yuliusd/I-Gauge/README.md

# I-Gauge
Open Source Hardware for monitoring water pipe pressure
