yuliusd/I-Gauge/I-GAUGE LoRa EndNode.png

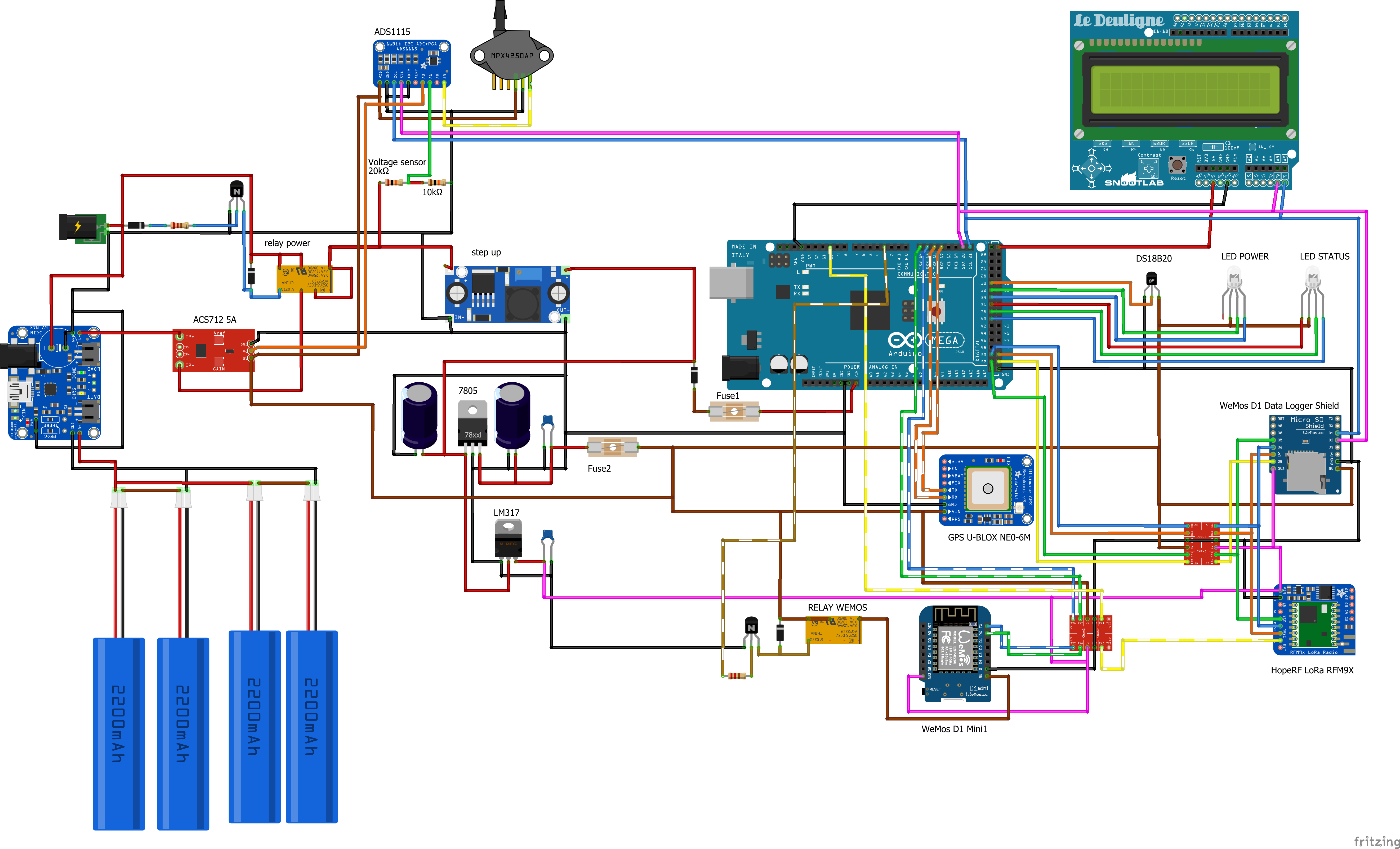
I-GAUGE LoRa EndNode.png
