yuliusd/I-Gauge/i-gauge LoRa Gateway.png

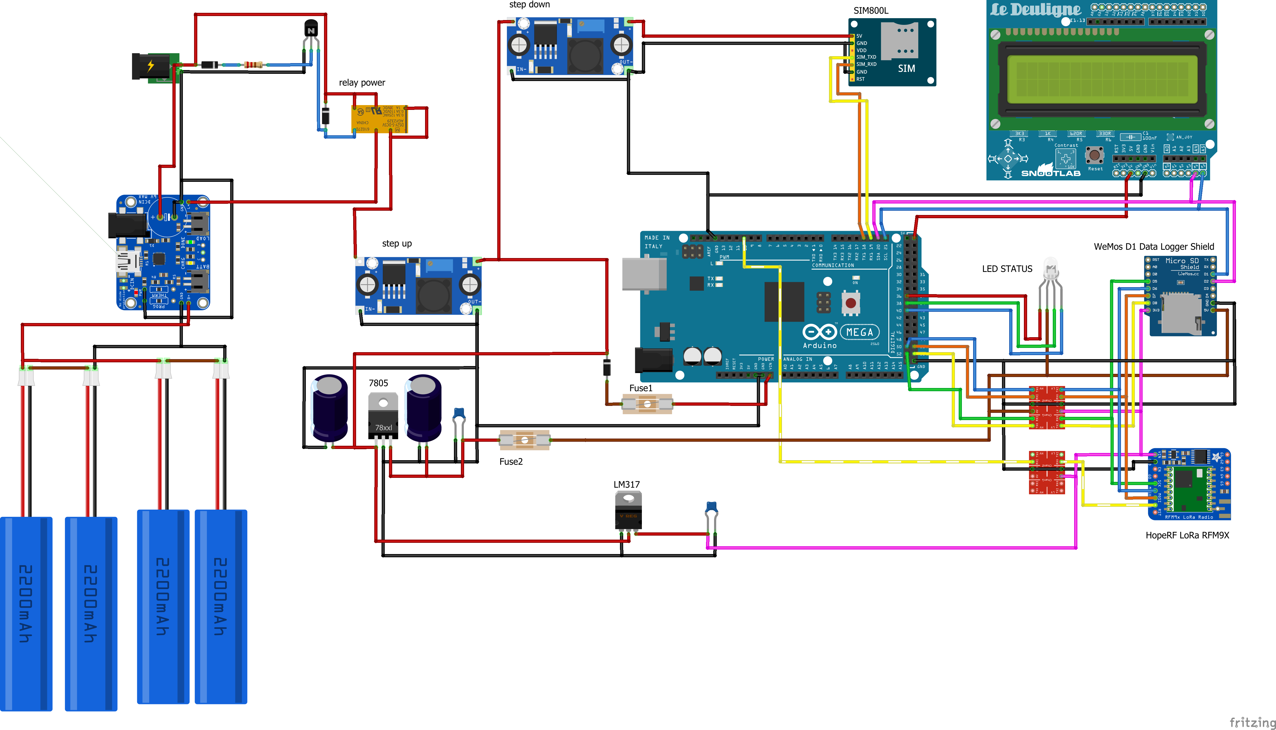
i-gauge LoRa Gateway.png
