yuliusd/I-Gauge/I-GAUGE_versi complete.png

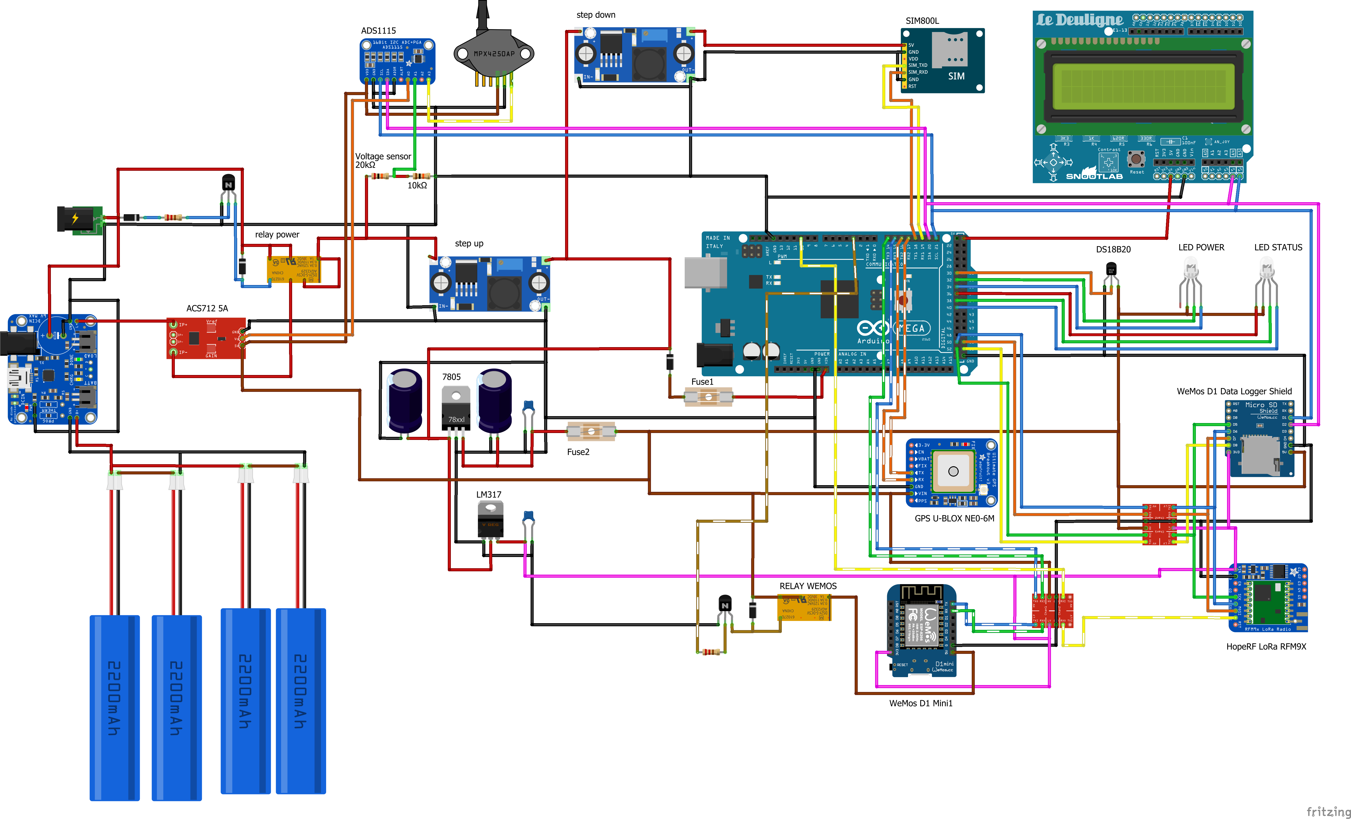
I-GAUGE_versi complete.png
