yuliusd/I-Gauge/igauge.png

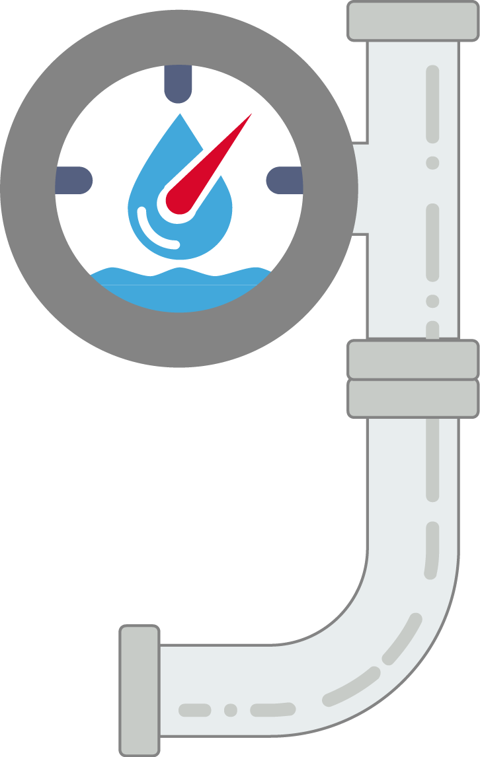
igauge.png
