yuliusd/I-Gauge/(list of files, drawings)

Other design files:
I-GAUGE COMPLETE VERSION.fzz
I-GAUGE LoRa EndNode.fzz
i-gauge LoRa Gateway.fzz
