yuliusd/I-Gauge/IGauge+V.2.2.brd

## EAGLE design IGauge+V.2.2.brd (2018-05-09, an earlier design)

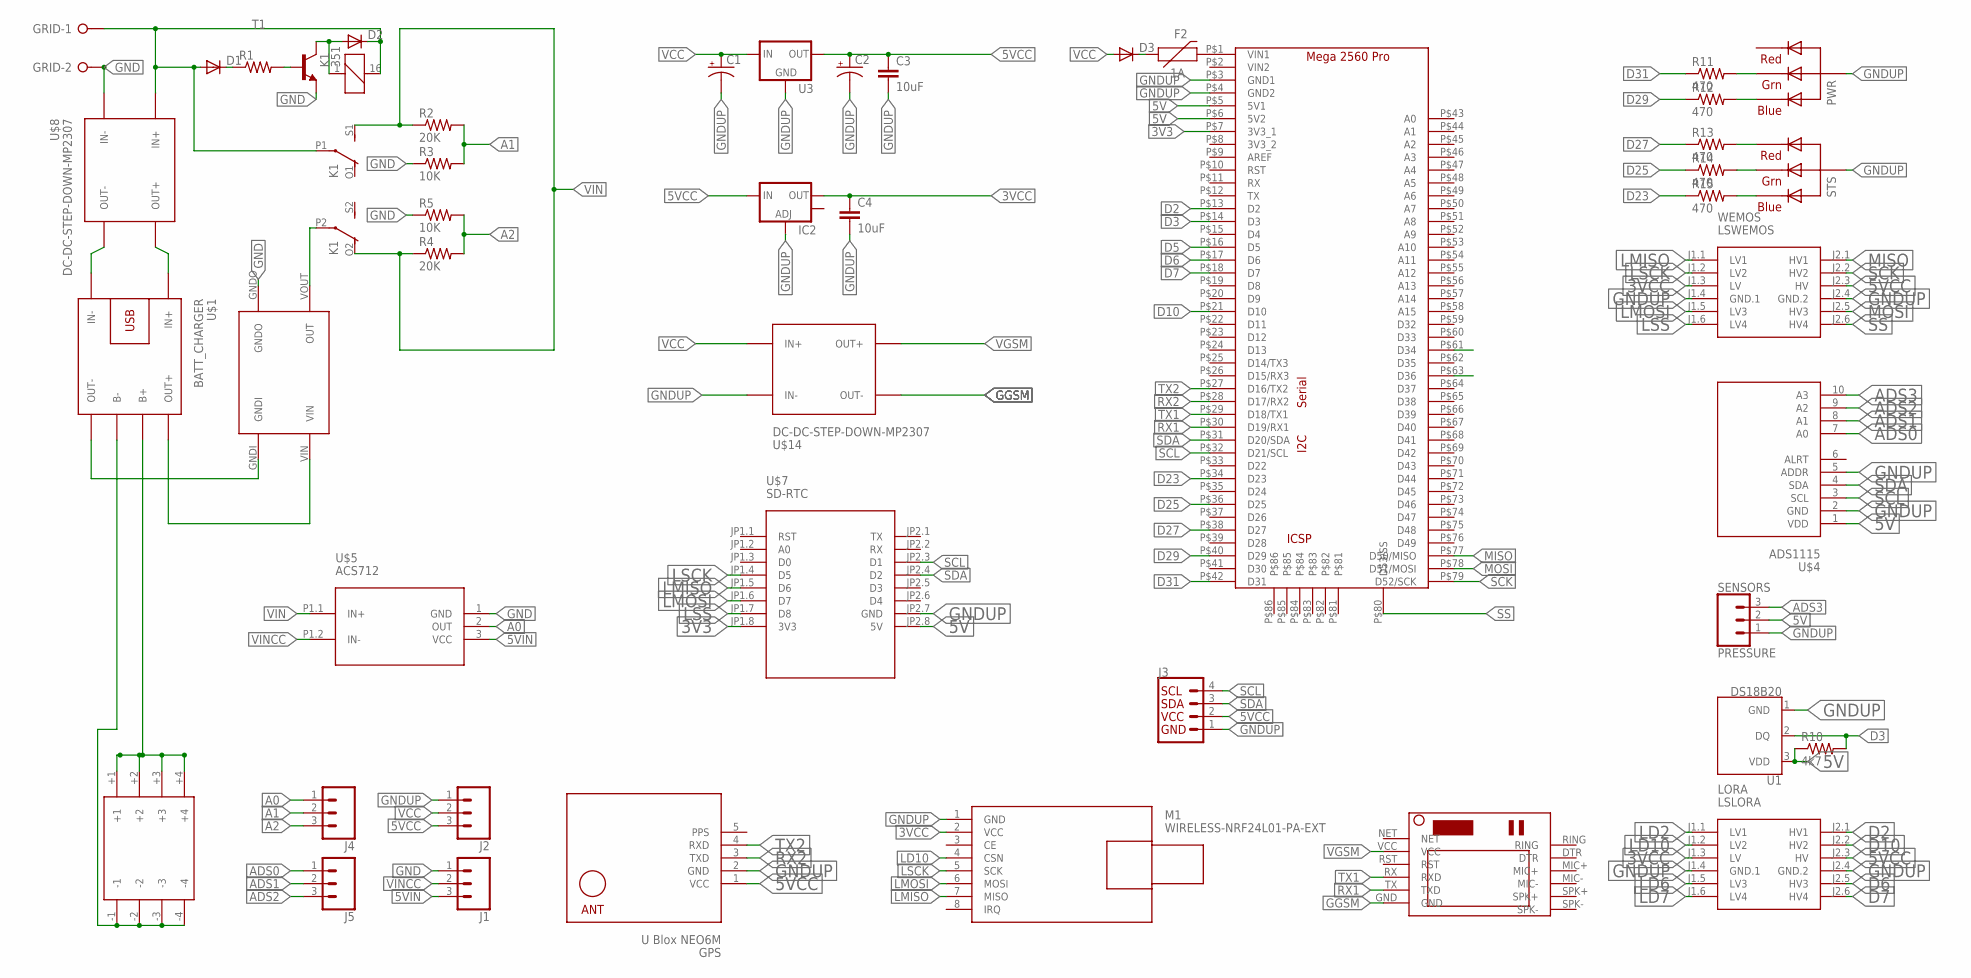
[picture p5: schematic IGauge+V.2.2.sch]

Parts:
C1, C2: CPOL-USD; PANASONIC_D
C3, C4: 10uF; 1206
D1, D2, D3: DIODE-SOD106A-R; SOD106A-R
F2: 1A; 1206
GPS: U Blox NEO6M; GPS-RECEIVER-NEO6M
GRID: W237-02P; W237-132
IC2: V_REG_LM1117SOT223; SOT223
J1, J2, J4, J5: CONN_03; 1X03
J3: I2C_STANDARD; 1X04
K1: 351
LORA: LSLORA; LEVEL-SHIFTER-4CH
M1: WIRELESS-NRF24L01-PA-EXT
PWR: RGBLED_CA-5MM; LED5MMRGB
R1: R-US_R1206; R1206
R2, R4: 20K; R1206
R3, R5: 10K; R1206
R10: 4k7; M1406
R11, R12, R13, R14, R15: 470; R1206
SENSORS: PRESSURE; MOLEX-1X3
STS: RGBLED_CA-5MM; LED5MMRGB
T1: -NPN-SOT23-EBC; SOT23-EBC
U1: DS18B20; TO-92-AMMO
U3: V_REG_78XX-TO-220; TO-220-ALT
U$1: BATT_CHARGER; BATTERY-CHARGER-LI-PROT
U$2: MT360_STEPUP
U$3: MEGAPROMINI
U$4: ADS1115; ADC-4CH-ADS1115
U$5: ACS712; CURRENT-SENSOR-ACS712#IC
U$7: SD-RTC; WEMOS-D1-MINI-SHIELD
U$8, U$14: DC-DC-STEP-DOWN-MP2307
U$9: 18650_4PCS_BATTERY_HOLDER
U$10: SIM800LMODULE
WEMOS: LSWEMOS; LEVEL-SHIFTER-4CH

Connections:
3V3: U$3.P$7 (3V3_1), U$7.JP1.8 (3V3)
3VCC: C4.1, IC2.2 (OUT), LORA.J1.3 (LV), M1.2 (VCC), WEMOS.J1.3 (LV)
5V: R10.1, SENSORS.2, U1.3 (VDD), U$3.P$5 (5V1), U$3.P$6 (5V2), U$4.1 (VDD), U$7.JP2.8 (5V)
5VCC: C2.+, C3.1, GPS.1 (VCC), IC2.3 (IN), J2.3, J3.2, LORA.J2.3 (HV), U3.OUT, WEMOS.J2.3 (HV)
5VIN: J1.3, U$5.3 (VCC)
A0: J4.1, U$5.2 (OUT)
A1: J4.2, R2.2, R3.2
A2: J4.3, R4.2, R5.2
ADS0: J5.1, U$4.7 (A0)
ADS1: J5.2, U$4.8 (A1)
ADS2: J5.3, U$4.9 (A2)
ADS3: SENSORS.3, U$4.10 (A3)
D2: LORA.J2.1 (HV1), U$3.P$13 (D2)
D3: R10.2, U1.2 (DQ), U$3.P$14 (D3)
D5: U$3.P$16 (D5)
D6: LORA.J2.5 (HV3), U$3.P$17 (D6)
D7: LORA.J2.6 (HV4), U$3.P$18 (D7)
D10: LORA.J2.2 (HV2), U$3.P$21 (D10)
D23: R15.1, U$3.P$34 (D23)
D25: R14.1, U$3.P$36 (D25)
D27: R13.1, U$3.P$38 (D27)
D29: R12.1, U$3.P$40 (D29)
D31: R11.1, U$3.P$42 (D31)
D34: U$3.P$61 (D34)
D36: U$3.P$63 (D36)
GGSM: U$10.GND, U$14.OUT-
GND: D1.A, D2.C, GRID.1, GRID.2, J1.1, K1.16 (2), K1.P1, R3.1, R5.1, T1.E, U$2.GNDO, U$5.1 (GND), U$8.IN+, U$8.IN-
GNDUP: C1.-, C2.-, C3.2, C4.2, GPS.2 (GND), IC2.1 (ADJ), J2.1, J3.1, LORA.J1.4 (GND.1), LORA.J2.4 (GND.2), M1.1 (GND), PWR.2 (VCC), SENSORS.1, STS.2 (VCC), U1.1 (GND), U3.GND, U$1.IN-, U$3.P$3 (GND1), U$3.P$4 (GND2), U$4.2 (GND), U$4.5 (ADDR), U$7.JP2.7 (GND), U$8.OUT-, U$14.IN-, WEMOS.J1.4 (GND.1), WEMOS.J2.4 (GND.2)
LD2: LORA.J1.1 (LV1)
LD6: LORA.J1.5 (LV3)
LD7: LORA.J1.6 (LV4)
LD10: LORA.J1.2 (LV2), M1.4 (CSN)
LMISO: M1.7 (MISO), U$7.JP1.5 (D6), WEMOS.J1.1 (LV1)
LMOSI: M1.6 (MOSI), U$7.JP1.6 (D7), WEMOS.J1.5 (LV3)
LSCK: M1.5 (SCK), U$7.JP1.4 (D5), WEMOS.J1.2 (LV2)
LSS: U$7.JP1.7 (D8), WEMOS.J1.6 (LV4)
MISO: U$3.P$77 (D50/MISO), WEMOS.J2.1 (HV1)
MOSI: U$3.P$78 (D51/MOSI), WEMOS.J2.5 (HV3)
unnamed: U$1.OUT-, U$2.GNDI
unnamed: D1.C, R1.1
unnamed: PWR.3 (GREEN), R11.2
unnamed: F2.2, U$3.P$1 (VIN1)
unnamed: D3.C, F2.1
unnamed: U$1.OUT+, U$2.VIN
unnamed: U$1.IN+, U$8.OUT+
unnamed: PWR.4 (BLUE), R12.2
unnamed: R13.2, STS.1 (RED)
unnamed: R1.2, T1.B
unnamed: D2.A, K1.1, T1.C
unnamed: U$1.B+, U$9.+1, U$9.+2, U$9.+3, U$9.+4
unnamed: U$1.B-, U$9.-1, U$9.-2, U$9.-3, U$9.-4
unnamed: R14.2, STS.3 (GREEN)
unnamed: R15.2, STS.4 (BLUE)
unnamed: K1.P2, U$2.VOUT (OUT)
PPS: GPS.5 (PPS)
RX1: U$3.P$30 (D19/RX1), U$10.TX (TXD)
RX2: GPS.3 (TXD), U$3.P$28 (D17/RX2)
SCK: U$3.P$79 (D52/SCK), WEMOS.J2.2 (HV2)
SCL: J3.4, U$3.P$32 (D21/SCL), U$4.3 (SCL), U$7.JP2.3 (D1)
SDA: J3.3, U$3.P$31 (D20/SDA), U$4.4 (SDA), U$7.JP2.4 (D2)
SS: U$3.P$80 (D53/SS), WEMOS.J2.6 (HV4)
TX1: U$3.P$29 (D18/TX1), U$10.RX (RXD)
TX2: GPS.4 (RXD), U$3.P$27 (D16/TX2)
VCC: C1.+, D3.A, J2.2, U3.IN, U$14.IN+
VGSM: U$10.VCC, U$14.OUT+
VIN: K1.O2 (O), K1.S1 (S), R2.1, R4.1, U$5.P1.1 (IN+)
VINCC: J1.2, U$5.P1.2 (IN-)

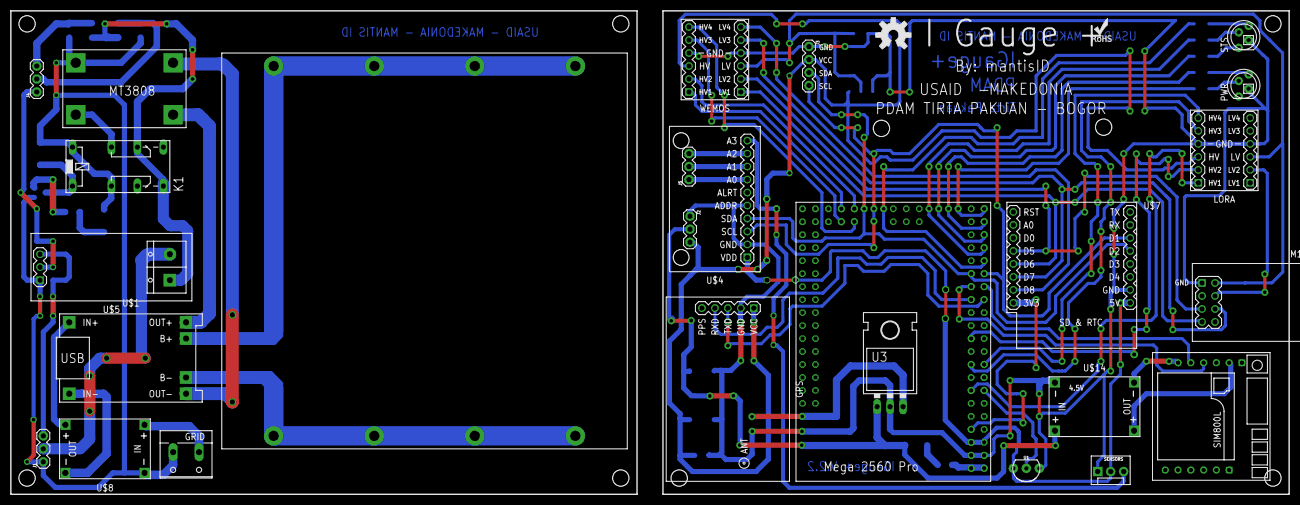
[picture p6: board IGauge+V.2.2.brd from above]

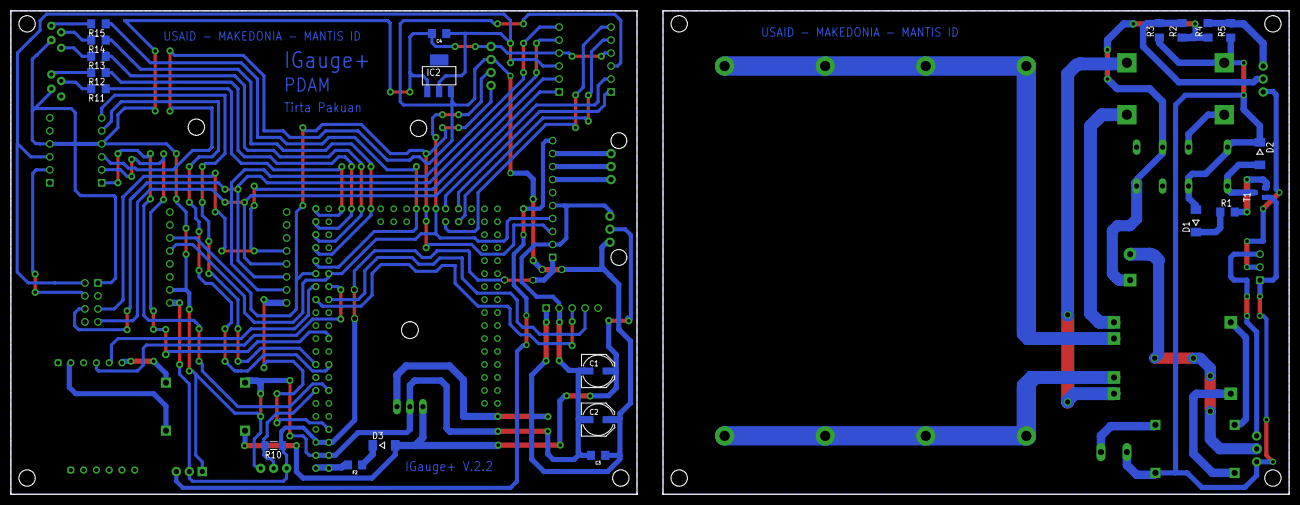
[picture p7: board IGauge+V.2.2.brd from below]

Board: 2 copper layers, 250.2 x 94.6 mm, 49 parts (21 on the bottom side), 60 nets.

Other parts of the board:
U$12: OSHW-LOGO-L
U$13: ROHS_LOGO_0.18_IN
