yuliusd/I-Gauge/IGauge+V.2.3.brd

## EAGLE design IGauge+V.2.3.brd (2018-04-26)

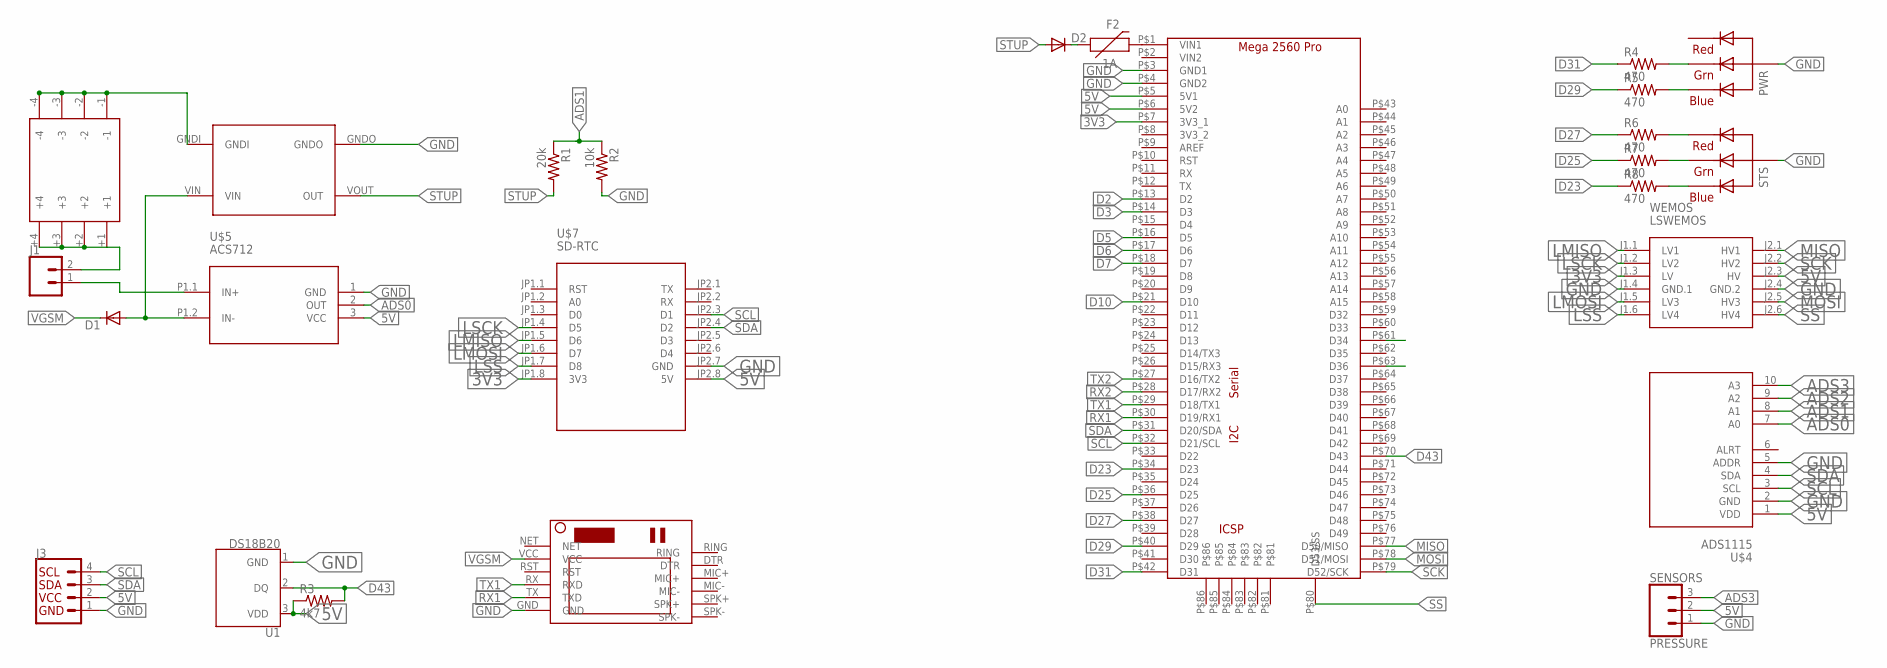
[picture p8: schematic IGauge+V.2.3.sch]

Parts:
D1, D2: DIODE-SOD106A-R; SOD106A-R
F2: 1A; 1206
J1: CONN_02; 1X02
J3: I2C_STANDARD; 1X04
PWR: RGBLED_CA-5MM; LED5MMRGB
R1: 20k; R1206
R2: 10k; R1206
R3: 4k7; M1406
R4, R5, R6, R7, R8: 470; R1206
SENSORS: PRESSURE; MOLEX-1X3
STS: RGBLED_CA-5MM; LED5MMRGB
U1: DS18B20; TO-92-AMMO
U$2: MT360_STEPUP
U$3: MEGAPROMINI
U$4: ADS1115; ADC-4CH-ADS1115
U$5: ACS712; CURRENT-SENSOR-ACS712#IC
U$7: SD-RTC; WEMOS-D1-MINI-SHIELD
U$9: 18650_4PCS_BATTERY_HOLDER
U$10: SIM800LMODULE
WEMOS: LSWEMOS; LEVEL-SHIFTER-4CH

Connections:
3V3: U$3.P$7 (3V3_1), U$7.JP1.8 (3V3), WEMOS.J1.3 (LV)
5V: J3.2, R3.1, SENSORS.2, U1.3 (VDD), U$3.P$5 (5V1), U$3.P$6 (5V2), U$4.1 (VDD), U$5.3 (VCC), U$7.JP2.8 (5V), WEMOS.J2.3 (HV)
ADS0: U$4.7 (A0), U$5.2 (OUT)
ADS1: R1.1, R2.1, U$4.8 (A1)
ADS2: U$4.9 (A2)
ADS3: SENSORS.3, U$4.10 (A3)
D2: U$3.P$13 (D2)
D3: U$3.P$14 (D3)
D5: U$3.P$16 (D5)
D6: U$3.P$17 (D6)
D7: U$3.P$18 (D7)
D10: U$3.P$21 (D10)
D23: R8.1, U$3.P$34 (D23)
D25: R7.1, U$3.P$36 (D25)
D27: R6.1, U$3.P$38 (D27)
D29: R5.1, U$3.P$40 (D29)
D31: R4.1, U$3.P$42 (D31)
D34: U$3.P$61 (D34)
D36: U$3.P$63 (D36)
D43: R3.2, U1.2 (DQ), U$3.P$70 (D43)
GND: J3.1, PWR.2 (VCC), R2.2, SENSORS.1, STS.2 (VCC), U1.1 (GND), U$2.GNDO, U$3.P$3 (GND1), U$3.P$4 (GND2), U$4.2 (GND), U$4.5 (ADDR), U$5.1 (GND), U$7.JP2.7 (GND), U$10.GND, WEMOS.J1.4 (GND.1), WEMOS.J2.4 (GND.2)
LMISO: U$7.JP1.5 (D6), WEMOS.J1.1 (LV1)
LMOSI: U$7.JP1.6 (D7), WEMOS.J1.5 (LV3)
LSCK: U$7.JP1.4 (D5), WEMOS.J1.2 (LV2)
LSS: U$7.JP1.7 (D8), WEMOS.J1.6 (LV4)
MISO: U$3.P$77 (D50/MISO), WEMOS.J2.1 (HV1)
MOSI: U$3.P$78 (D51/MOSI), WEMOS.J2.5 (HV3)
unnamed: J1.1, U$5.P1.1 (IN+)
unnamed: PWR.3 (GREEN), R4.2
unnamed: F2.2, U$3.P$1 (VIN1)
unnamed: D2.C, F2.1
unnamed: U$2.GNDI, U$9.-1, U$9.-4
unnamed: PWR.4 (BLUE), R5.2
unnamed: R6.2, STS.1 (RED)
unnamed: R7.2, STS.3 (GREEN)
unnamed: R8.2, STS.4 (BLUE)
RX1: U$3.P$30 (D19/RX1), U$10.TX (TXD)
RX2: U$3.P$28 (D17/RX2)
SCK: U$3.P$79 (D52/SCK), WEMOS.J2.2 (HV2)
SCL: J3.4, U$3.P$32 (D21/SCL), U$4.3 (SCL), U$7.JP2.3 (D1)
SDA: J3.3, U$3.P$31 (D20/SDA), U$4.4 (SDA), U$7.JP2.4 (D2)
SS: U$3.P$80 (D53/SS), WEMOS.J2.6 (HV4)
STUP: D2.A, R1.2, U$2.VOUT (OUT)
TX1: U$3.P$29 (D18/TX1), U$10.RX (RXD)
TX2: U$3.P$27 (D16/TX2)
VACS: D1.A, U$2.VIN, U$5.P1.2 (IN-)
VGSM: D1.C, U$10.VCC
VIN: J1.2, U$9.+1, U$9.+2, U$9.+3, U$9.+4

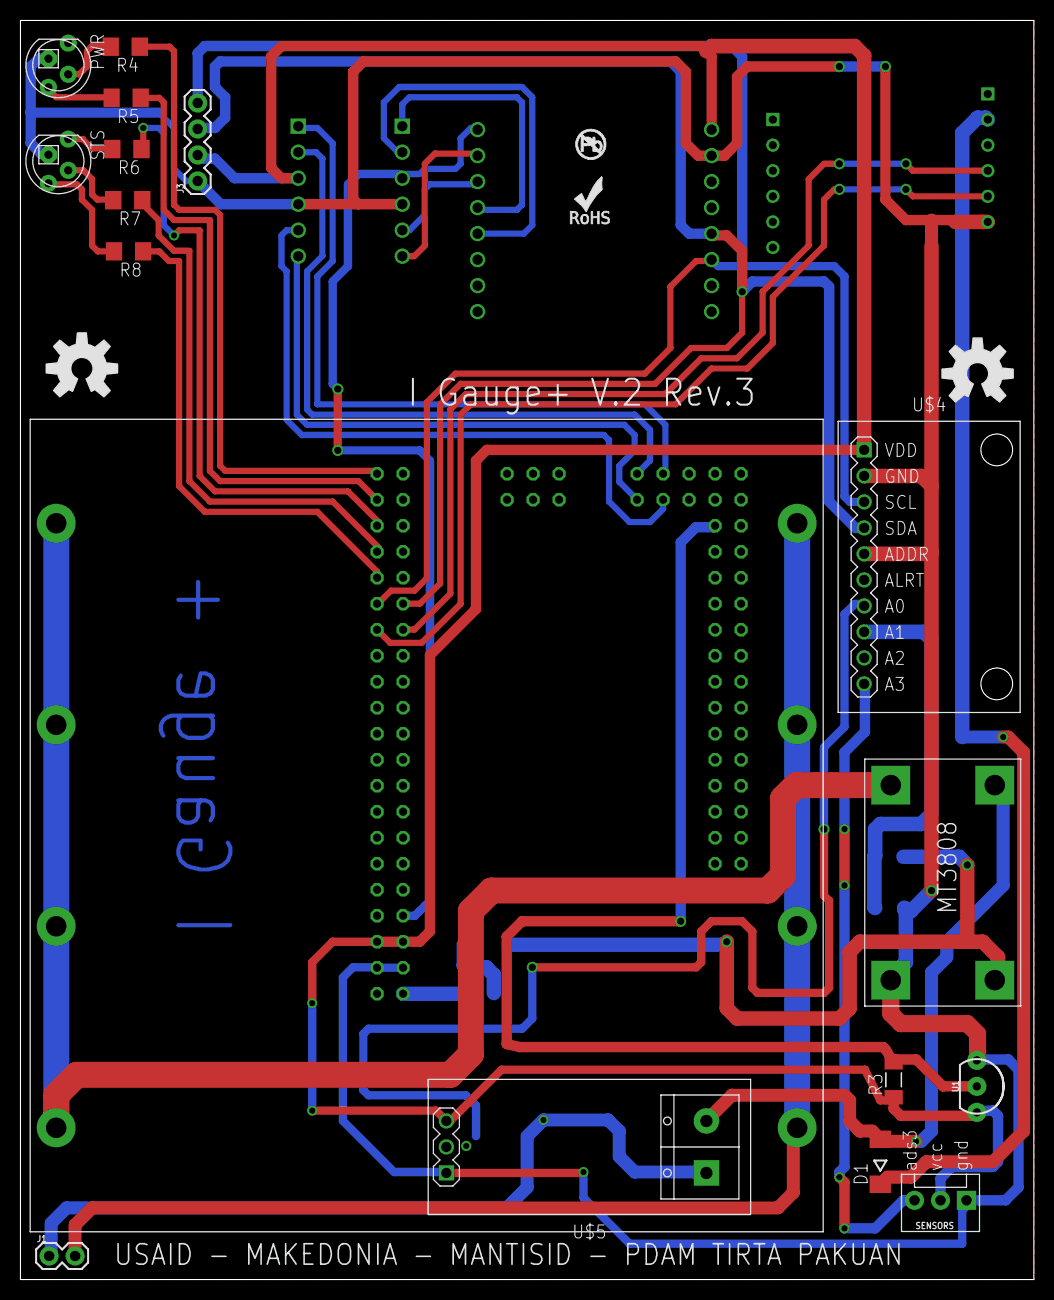
[picture p9: board IGauge+V.2.3.brd from above]

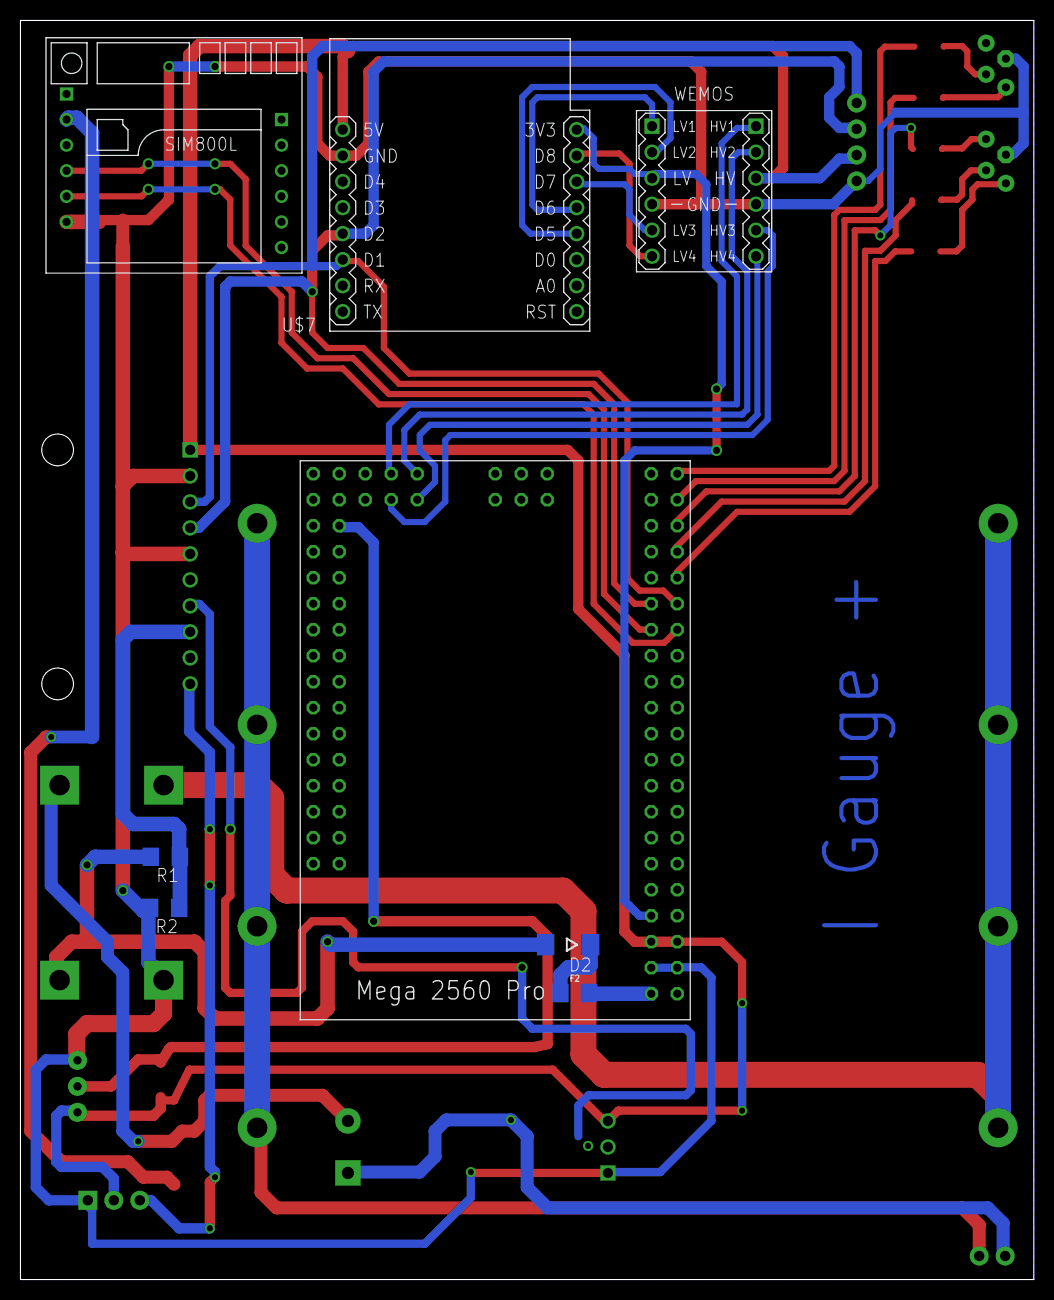
[picture p10: board IGauge+V.2.3.brd from below]

Board: 2 copper layers, 99.0 x 123.0 mm, 29 parts (8 on the bottom side), 37 nets.

Other parts of the board:
U$1: NO_PB_LOGO_0.120
U$6, U$8: OSHW-LOGO-L
U$11: ROHS_LOGO_0.18_IN
