yuliusd/I-Gauge/(commit log)

2017-10-24 Add files via upload
    Proteus simulation file
    [Arduino Mega 2560.pdsprj]
2017-11-03 Add files via upload
    Arduino sketch untuk wemos D1 esp8266.
    sketch ini digunakan untuk membuat webpage i-gauge configuration and data display
2017-12-10 Delete Arduino Mega 2560.pdsprj
    sudah tidk dibutuhkan lagi
    [Arduino Mega 2560.pdsprj]
2017-12-10 Add files via upload
    I-GAUGE Complete Version Schematic Design Using Fritzing.
    In this schematic, we use SIM800L to send data to server and LoRa to communicate with I-GAUGE LoRa Node.
2017-12-10 Add files via upload
    I-GAUGE COMPLETE VERSION Fritzing file
    [I-GAUGE COMPLETE VERSION.fzz]
2018-01-22 Add files via upload
    I-GAUGE V1 use 1.2 MPa pressure sensor, micro sd card, real-time clock, GPS, GSM-SIM800L, ACS712, ADS1115 and LCD 16x2.
    This version using wemos to change burst interval and data interval via the internal webpage. SIM800L used to send data to web server.
2018-01-25 Add files via upload
    Versi ini digunakan untuk I-GAUGE menggunakan baterai sebagai sumber tegangan utama. Fungsi LED di non aktifkan. Fungsi sleep ditambahkan
2018-04-26 schematic design I-GAUGE V.2.3
    final design for IGAUGE pcd development
    [IGauge+V.2.3.brd, IGauge+V.2.3.sch]
